esketi63/Mechatroniczny-LEJ-BOX-5.0/fritzing schemat.png

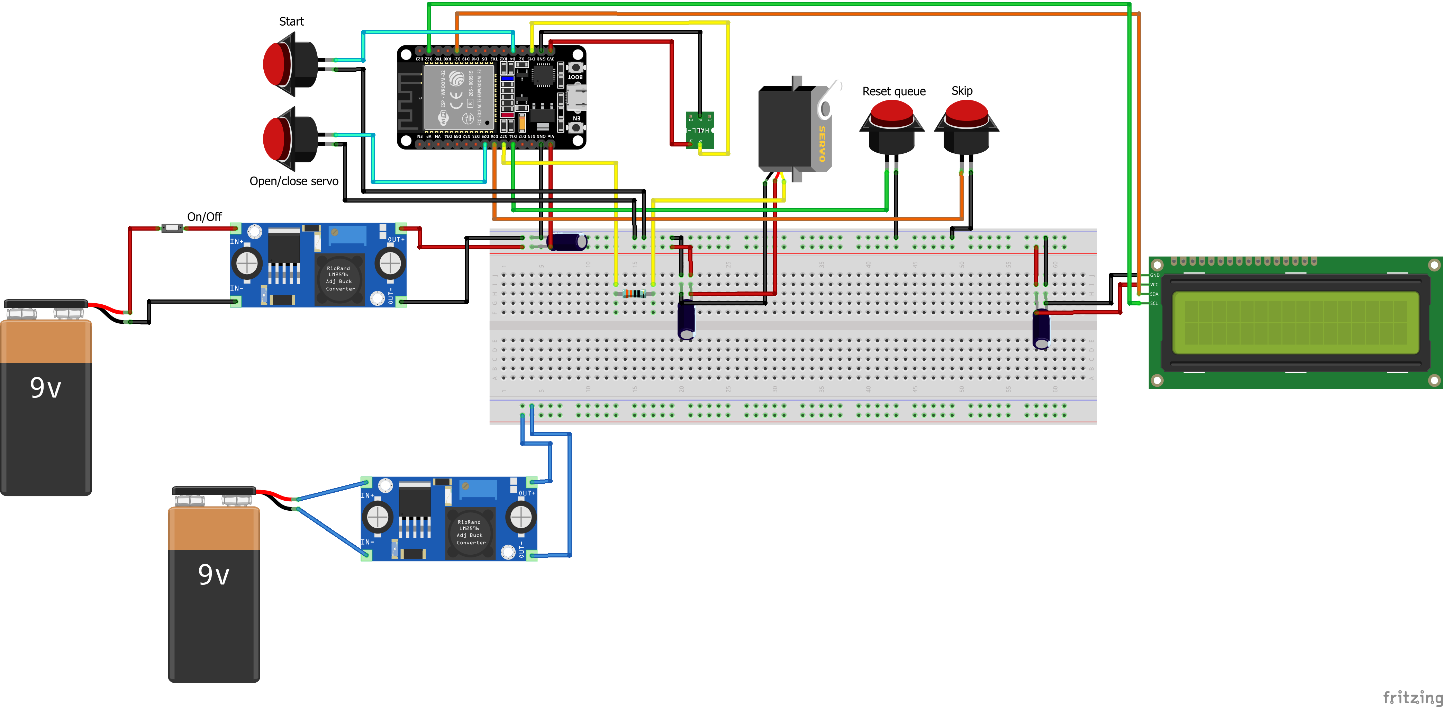
fritzing schemat.png
